Walessong/Robot_balance_car/APP配置.docx

1.打开蓝牙调试器，打开按钮控制，按照如下图片配置按键界面，注意一定要注意勾选“hex”。

2. 退出编辑模式，连接小车（设备名称JDY-69A-BL），即可遥控小车。默认情况下：01为前进、02为左转、03为右转，00停止

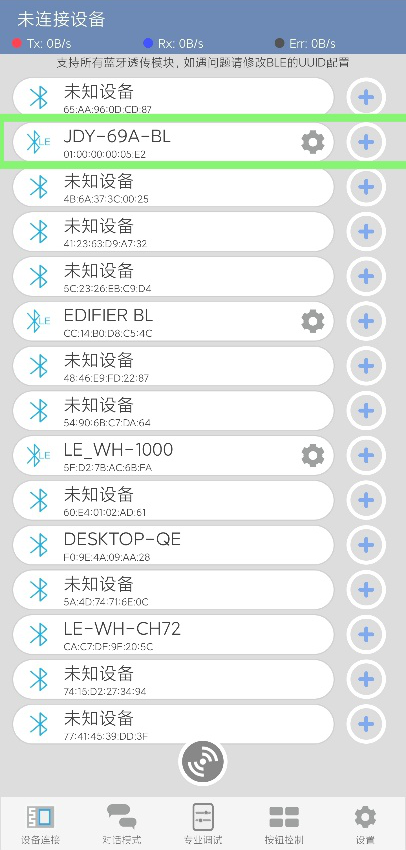
[picture p12: figure]
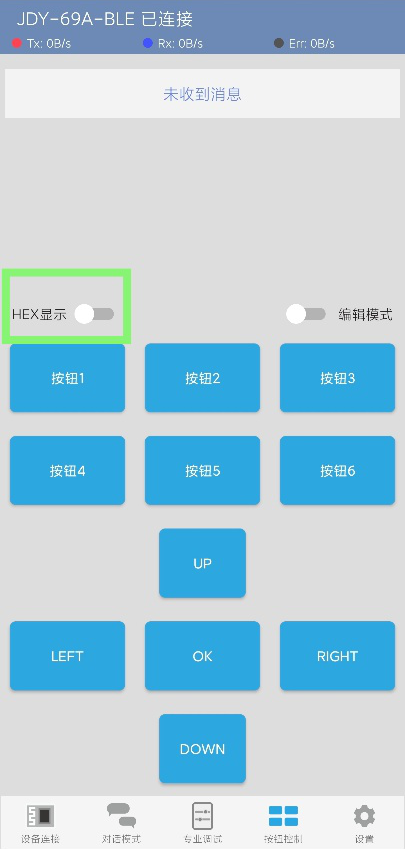
[picture p13: figure]
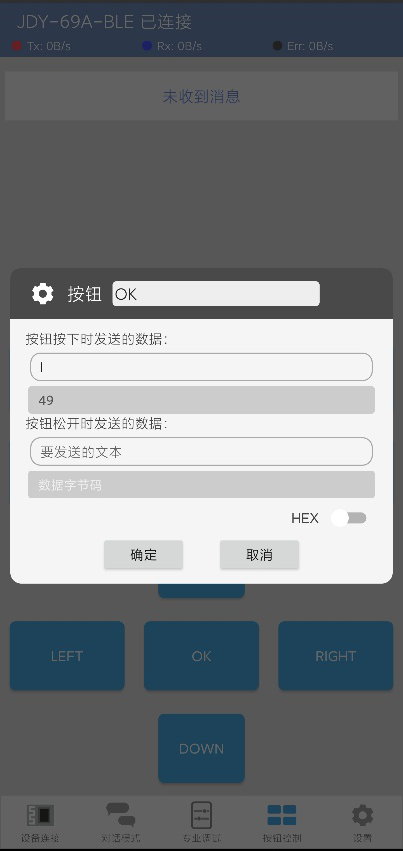
[picture p14: figure]
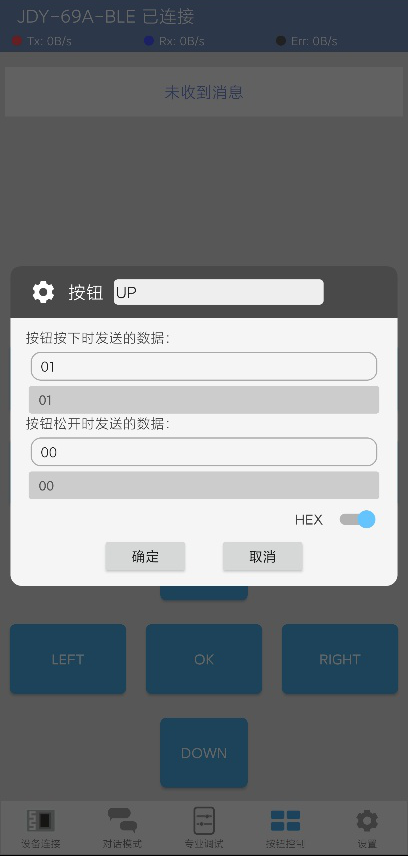
[picture p15: figure]
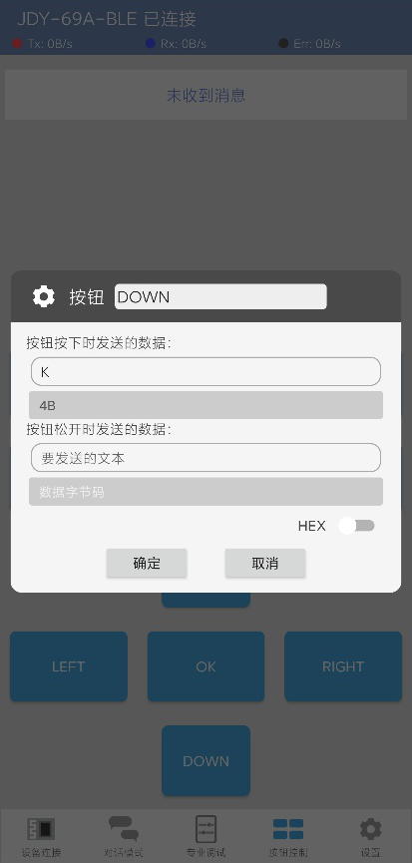
[picture p16: figure]
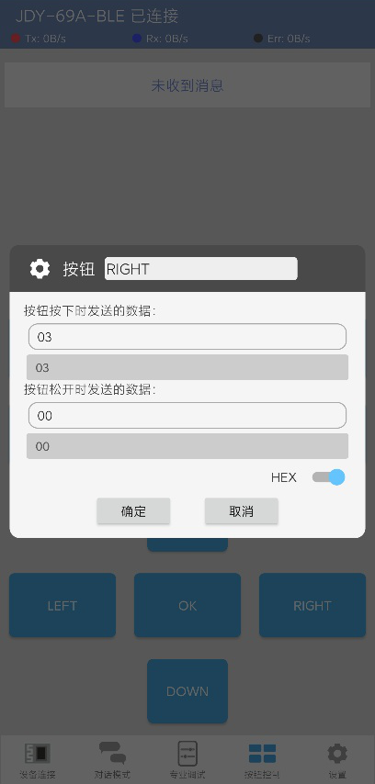
[picture p17: figure]
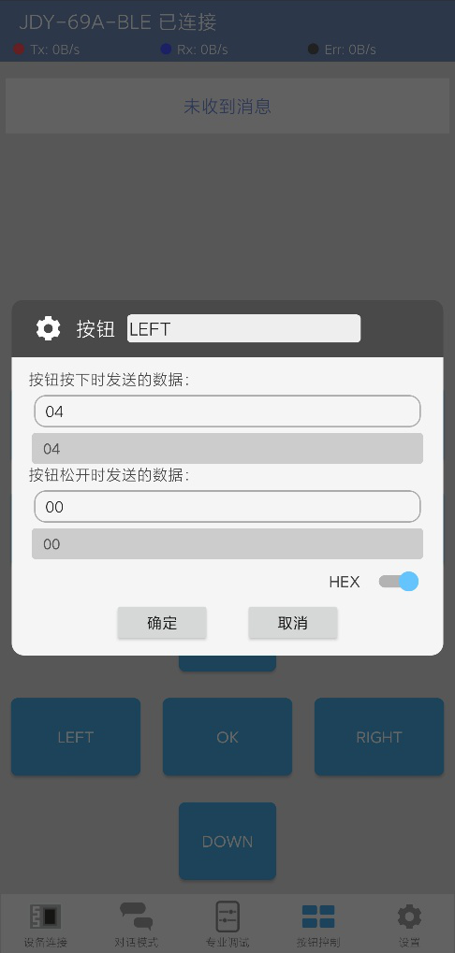
[picture p18: figure]
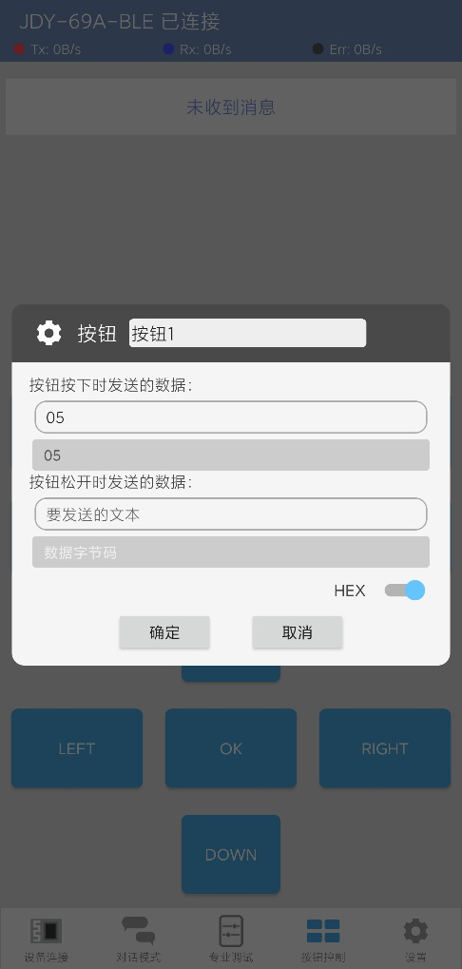
[picture p19: figure]
