Walessong/Robot_balance_car/img/app2.png

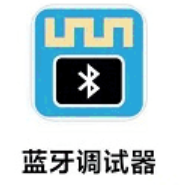
img/app2.png
