Walessong/Robot_balance_car/img/app.png

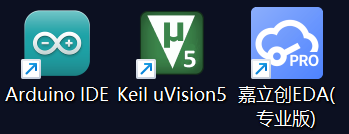
img/app.png
