Walessong/Robot_balance_car/img/cam7.jpg

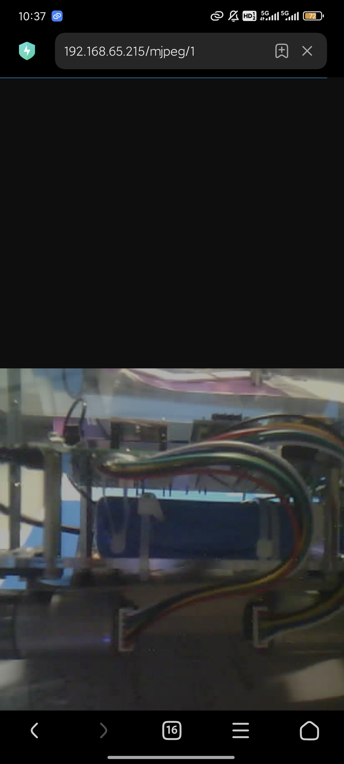
img/cam7.jpg
