Walessong/Robot_balance_car/效果图.jpg

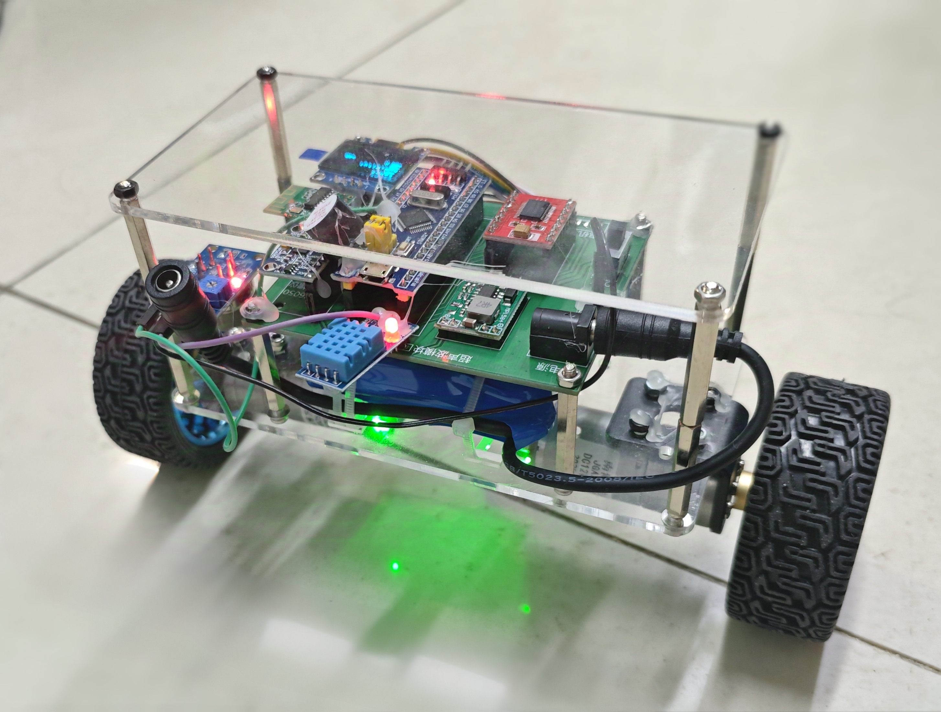
效果图.jpg
