Walessong/Robot_balance_car/模块/相关模块（新）.assets/image-20250429190427583-1746005888989-2.png

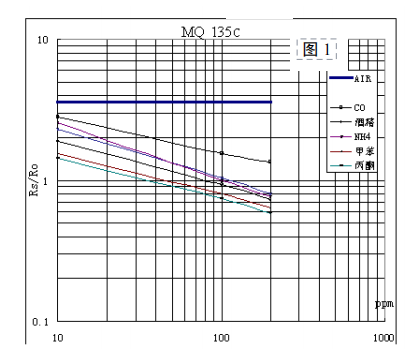
模块/相关模块（新）.assets/image-20250429190427583-1746005888989-2.png
