Walessong/Robot_balance_car/物料清单/物料清单.xlsx

类别 | 物料名称 | 数量 | 链接(无广，仅供参考) | 预算(供参考) | 备注
主要部分 | STM32F103C8T6最小系统板 | 1 | https://detail.tmall.com/item.htm?abbucket=20&id=738272568606&ns=1&skuId=5098758809471 | 14 | 排针向下焊
 | TB6612电机驱动板模块 | 1 | https://e.tb.cn/h.6OptrL1N2qDd9Ms?tk=OD4EVV95Bn7 | 3 | 钽电容耐压值35V的红色模块
 | 主控PCB | 1 | 嘉立创打样 | 20 | 每月可免费打样两次
 | 亚克力板 | 2 | https://e.tb.cn/h.6OkQ7s1mdHUG1bD?tk=1dmBVVOlFG7 | 20 | 底座和顶部
 | 20pin排母 | 6 | https://detail.tmall.com/item.htm?id=41234671442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 | 2.92
 | 排针20pin | 10 | https://detail.tmall.com/item.htm?id=609362740741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 | 3.12
 | MPU6050陀螺仪模块 | 1 | https://detail.tmall.com/item.htm?id=41337720621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 | 12.54 | 可能有质量问题导致初始化失败，及时更换
 | DC005电源插座 | 1 | https://e.tb.cn/h.6OpKssmhDoEnv4m?tk=64UUVV93fJm | 0.03
 | JDY68A(蓝牙模块) | 1 | https://e.tb.cn/h.6OpeX0rKEpwtWwk?tk=n7hLVVQJGF9 | 13
 | HC-SR04(超声波模块) | 1 | https://detail.tmall.com/item.htm?spm=a230r.1.14.9.66887fb5zIpYKx&id=41248598447&ns=1&abbucket=20 | 5.87
 | JGA25-370直流减速电机(带编码器带轮子及连接件)(6v 280转) | 2 | https://e.tb.cn/h.6OiVvgkcMpQwsnq?tk=RzYEVVj56dA | 60 | 两只(这个电机最便宜，而且带轮子，但性能不太好，但是能用)，预算充足可以看看轮趣家的，370电机
 | 0.96寸OLED | 1 | https://item.taobao.com/item.htm?id=43639171586&ns=1&abbucket=20 (https://item.taobao.com/item.htm?spm=a230r.1.14.3.566c2805SB81IJ&id=43639171586&ns=1&abbucket=20) | 10.8 | 新版本 gnd开头，颜色任选
 | MP1584EN DC-DC直流降压模块 | 1 | https://e.tb.cn/h.6O8SyikzdnoHLE9?tk=ToEqVV9Rhkh | 4.2 | 可以多买一个备用
 | m3铜柱（40mm) | 8 | https://detail.tmall.com/item.htm?abbucket=20&id=534856751282&ns=1&skuId=5095132382312 | 5.4 | 双通
 | m3*10螺丝 | 8 | https://detail.tmall.com/item.htm?abbucket=20&id=694131607161&ns=1&spm=a21n57.1.0.0.d90e523cXsUguI | 2.26 | m3*8，m3*12也可以买些
 | m3螺母防松 | 8 | https://detail.tmall.com/item.htm?abbucket=20&id=534828257082&ns=1&skuId=3192161696945 | 3.4
 | 18650锂电池组 | 1 | https://e.tb.cn/h.6ONXdoj8g6g8hLe?tk=hExdVV9L8H3 | 27 | 12V，带充电器
 | 18650锂电池组 | 1 | https://e.tb.cn/h.6OoxQYnJEV7TN3j?tk=WyscVVO83L3 | 20 | 5V，输出micro公头
 | 扎带 | 10 | https://e.tb.cn/h.6OpwcpZLEf0PEap?tk=OWP6VVQuHxn | 2 | 可拆卸版本更方便
拓展模块 | TMB12A05蜂鸣器 | 1 | https://e.tb.cn/h.6O798vQjcgzByTW?tk=eBr5VV8OjcK | 0.35
 | MQ-2烟雾气敏传感器模块 | 1 | https://e.tb.cn/h.6OlXEeJOkkL4i9Q?tk=fc6pVV8Nh55 | 6 | 不要只买探头
 | DHT11温湿度传感器模块 | 1 | https://e.tb.cn/h.6Ood4WCMUpJrj70?tk=Ex6uVV8oubg | 6
 | ESP32CAM | 1 | https://e.tb.cn/h.6OI0rxnCNr6FXNM?tk=5jPlVVOLhAF | 45 | 带烧录座
 | SG90 9g舵机 | 2 | https://e.tb.cn/h.6OlLFQ6L39h1WCq?tk=yDIxVVj2ZEo | 6 | 90-180通用
小计 |  |  |  | 292.89
工具类 | 电烙铁 | 1 |  | 30
 | 焊锡丝 | 1 |  | 10
 | 热熔胶枪 | 1 |  | 12 | 小功率的即可
 | 杜邦线 | 6 |  | 15 | 10cm、15cm、公对公、母对母、公对母
 | 小十字螺丝刀 | 1 |  | 2
 | 内六角螺丝刀 | 1 |  | 30 | 一套
 | jlink或者stlink | 1 |  | 10 | 下载器，烧录程序用
