Walessong/Robot_balance_car/物料清单/物料清单.png

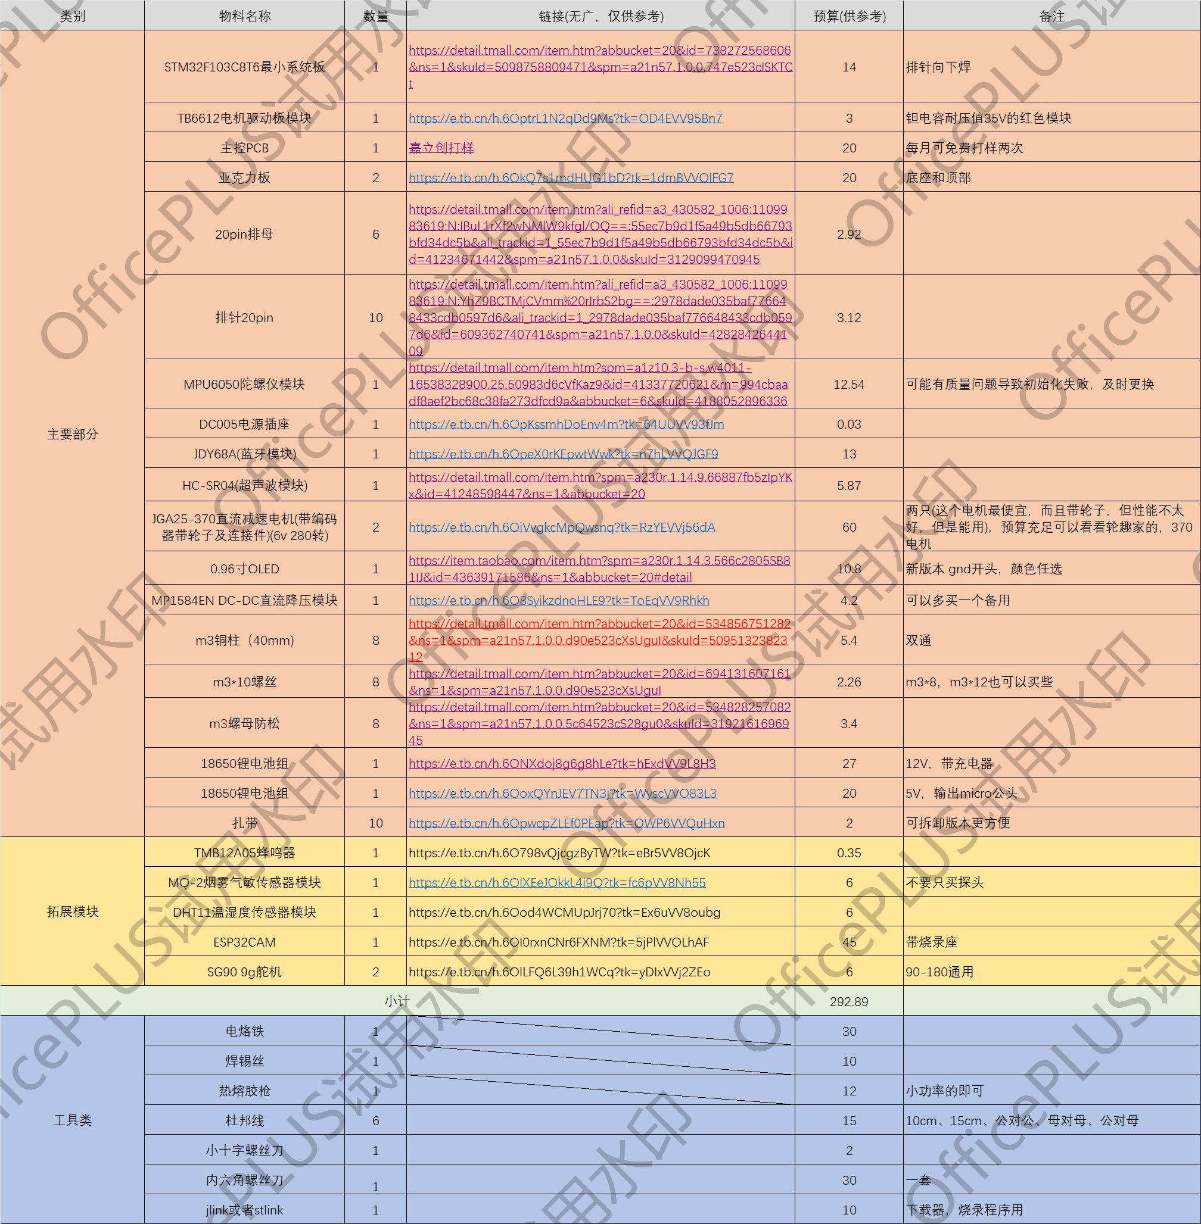
物料清单/物料清单.png
