Walessong/Robot_balance_car/PDF版原理图.pdf

# 电源接口 降压模块

# 蓝牙模块

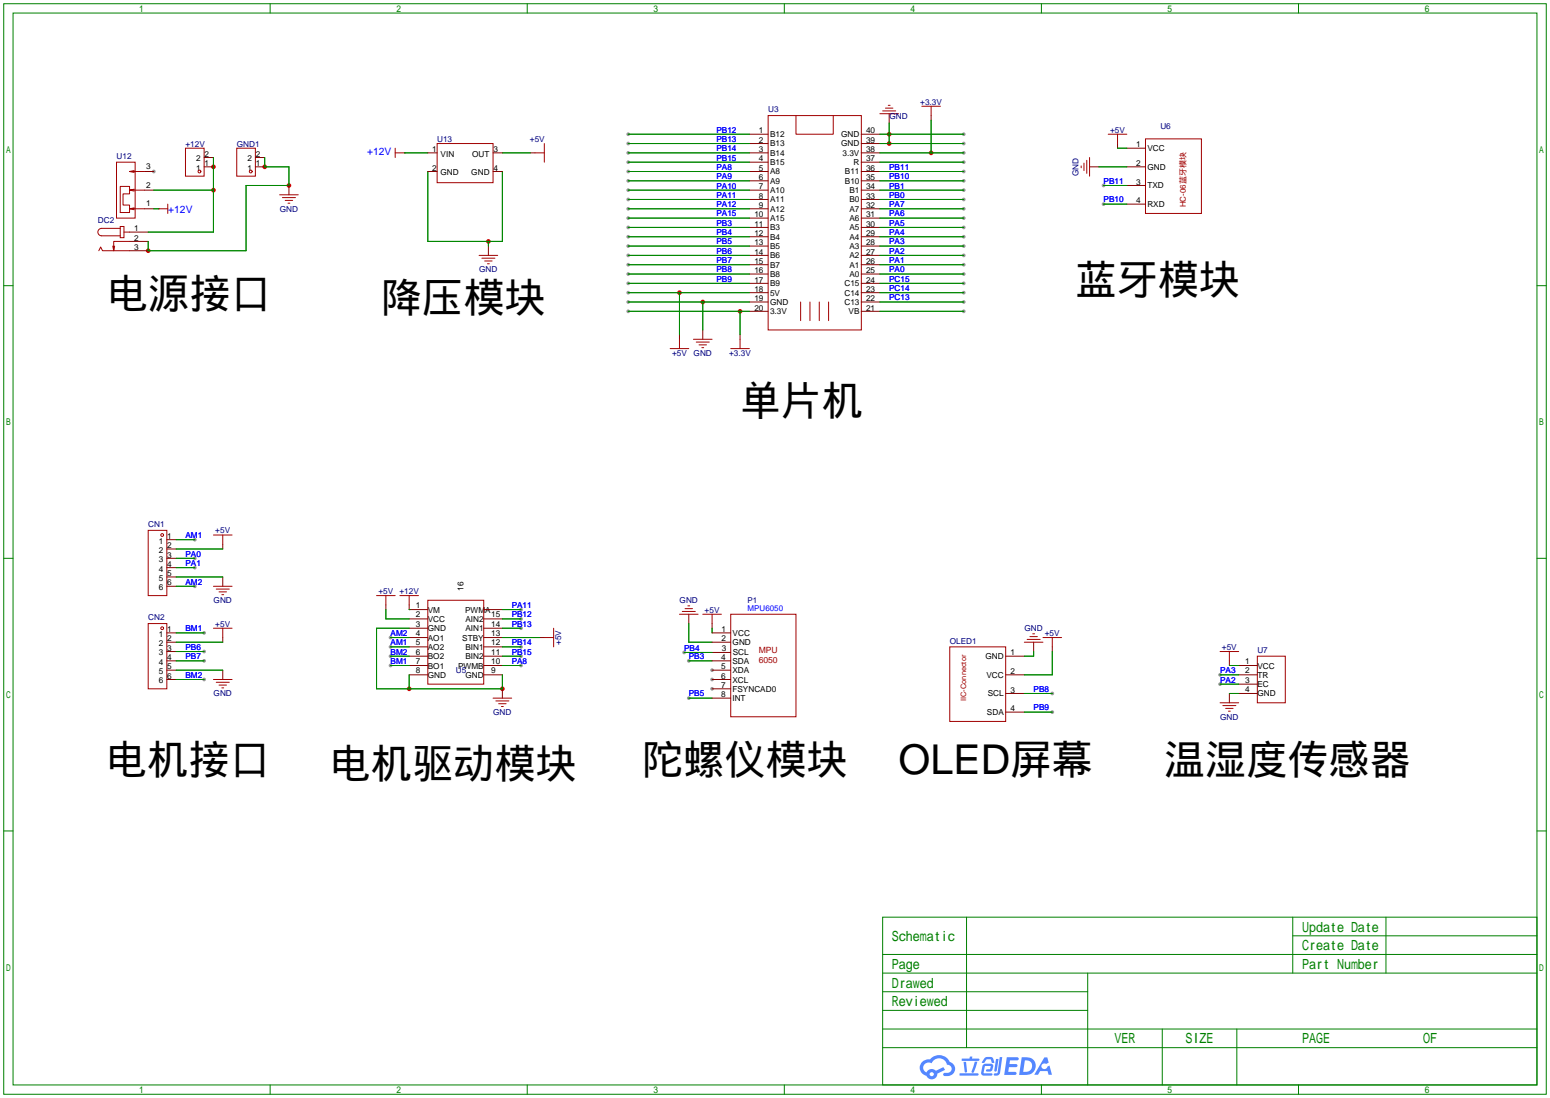
[picture p26: page 1]

PWMB 10 BIN2 11 BIN1 12 STBY 13 AIN1 14 AIN2 15 PWMA ¹⁶
