Walessong/Robot_balance_car/PCB_标准版_2025-04-28.pdf

电源

# MPU6050

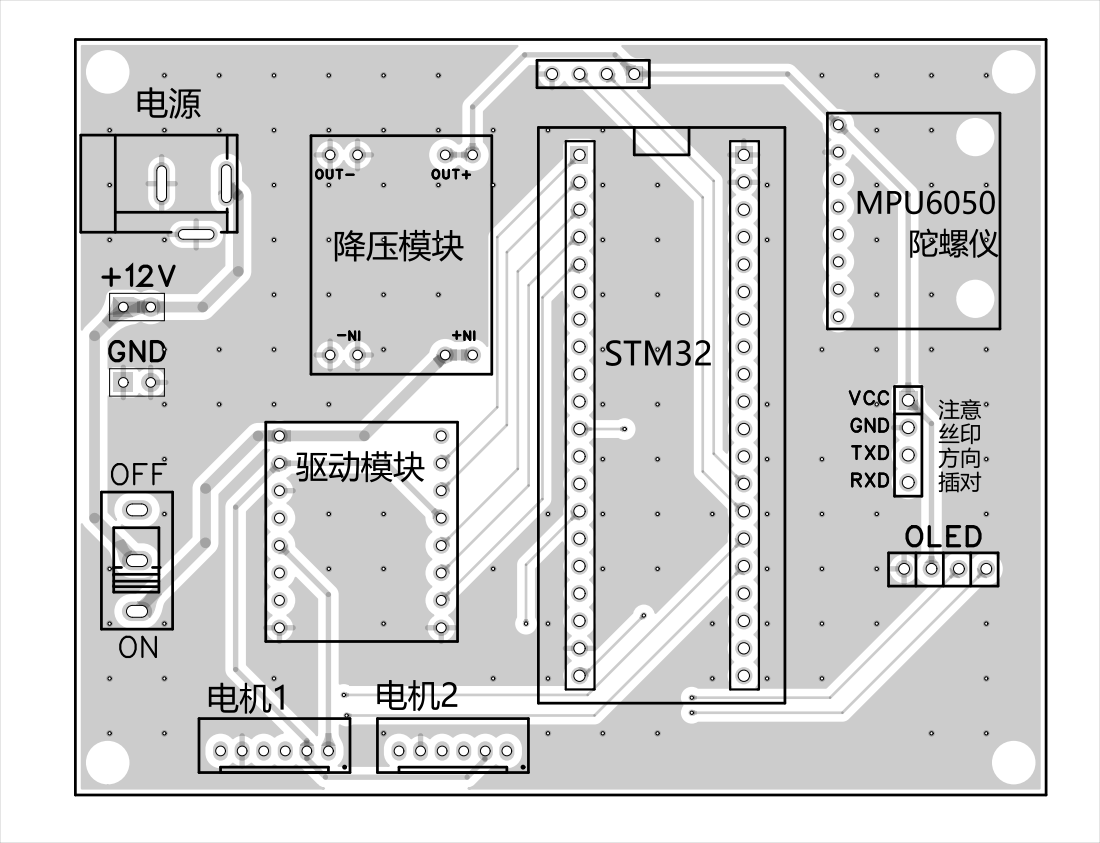
[picture p27: page 1]

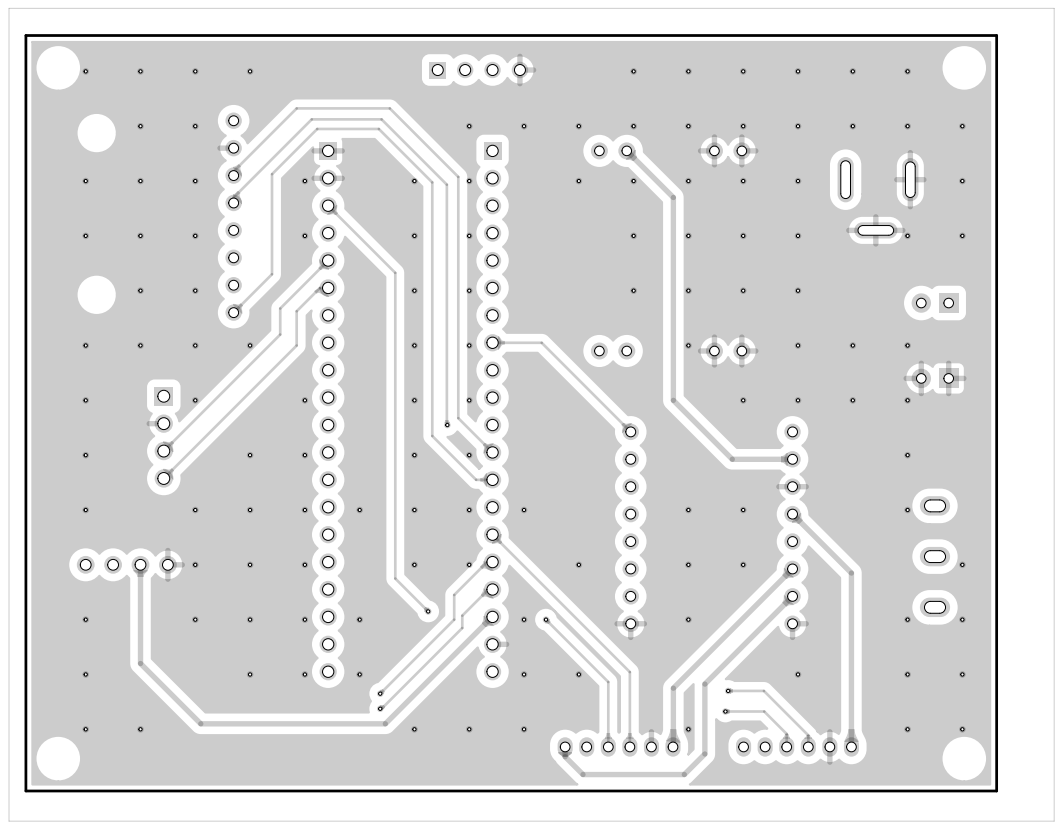
[picture p28: page 2]

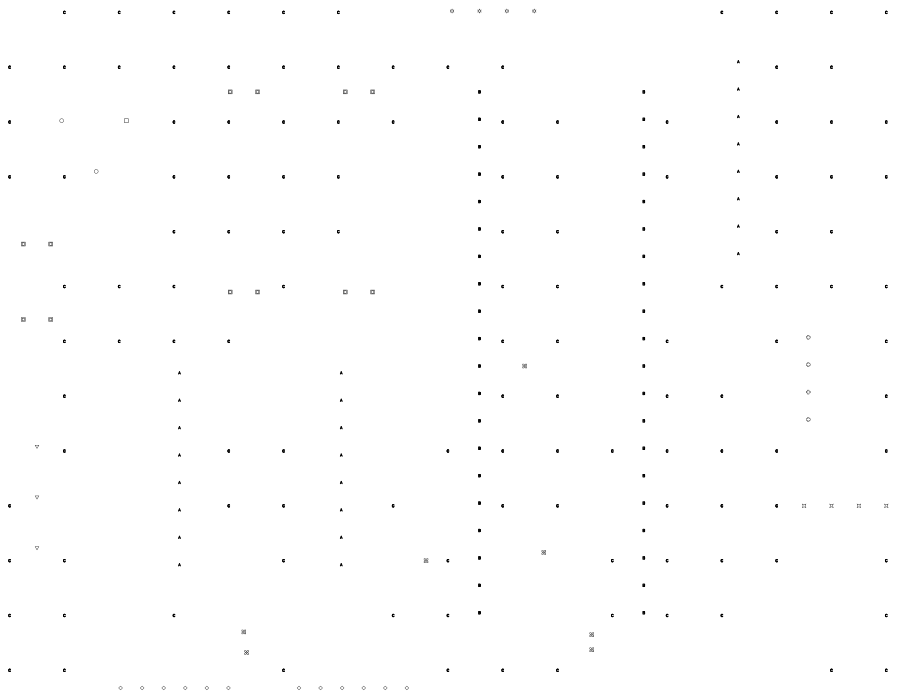
[picture p29: page 3]
