Walessong/Robot_balance_car/(list of files, drawings)

Other design files:
ProPrj_Robot_balance_car.epro
